tasminkhanelec-cmd/tic-tac-toe-hardware-gaming-interface-2023/media/Gameing Interface.png

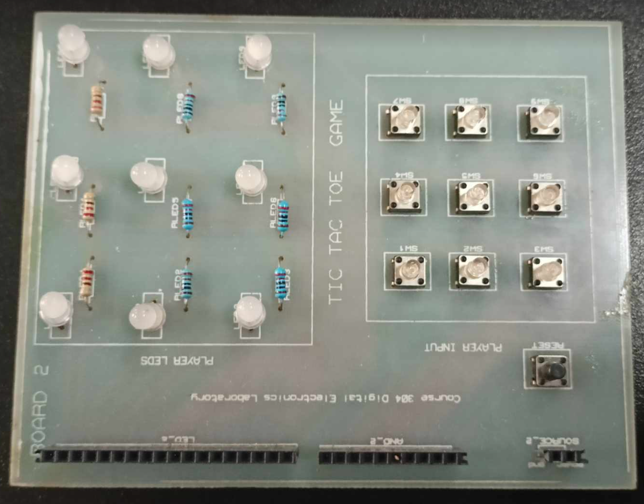
media/Gameing Interface.png
