tasminkhanelec-cmd/tic-tac-toe-hardware-gaming-interface-2023/circuit-design/schematics/player_identification_sim.png

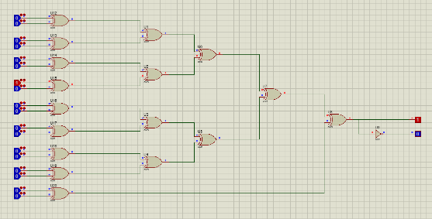
circuit-design/schematics/player_identification_sim.png
