tasminkhanelec-cmd/tic-tac-toe-hardware-gaming-interface-2023/circuit-design/schematics/stopping_game_sim.png

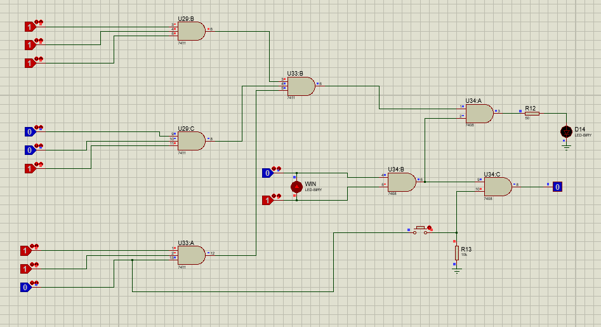
circuit-design/schematics/stopping_game_sim.png
