tasminkhanelec-cmd/tic-tac-toe-hardware-gaming-interface-2023/PCB-design/doc/Board1/Bottom Copper.pdf

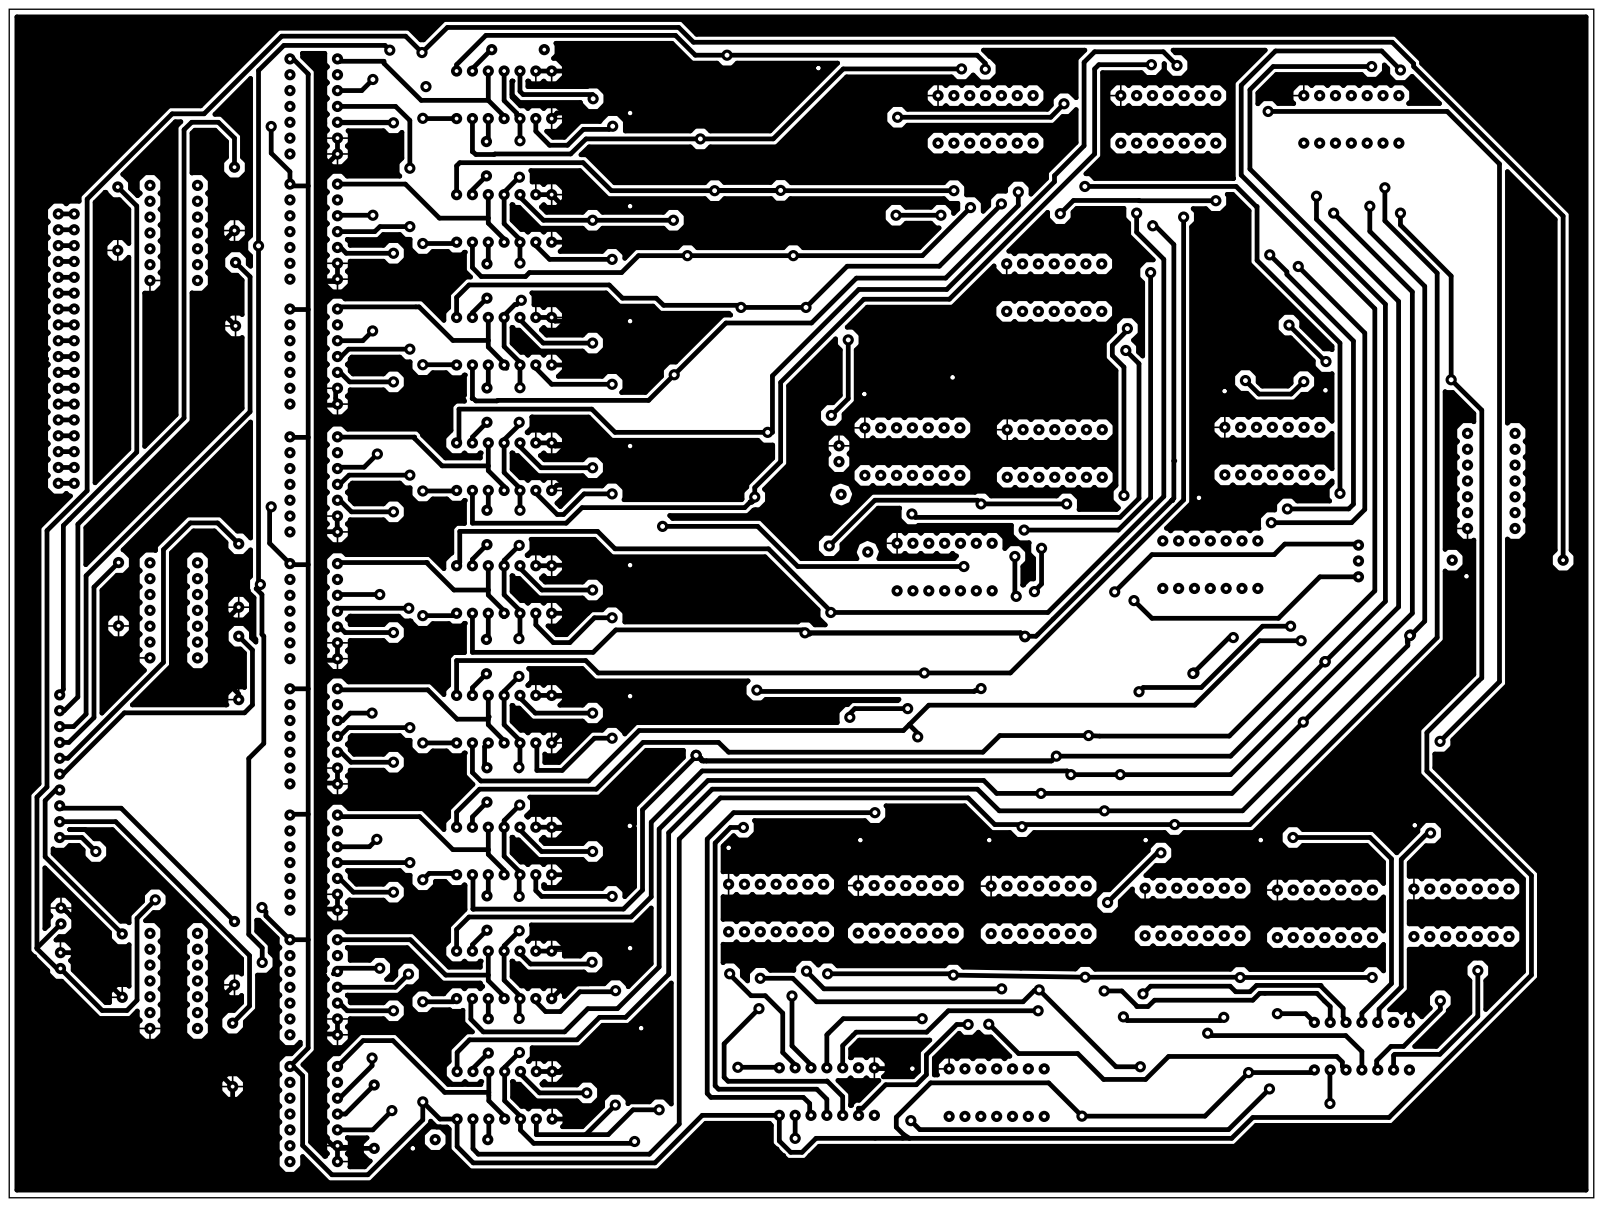
[picture p16: page 1]
