tasminkhanelec-cmd/tic-tac-toe-hardware-gaming-interface-2023/PCB-design/doc/Board1/Bottom Resist.pdf

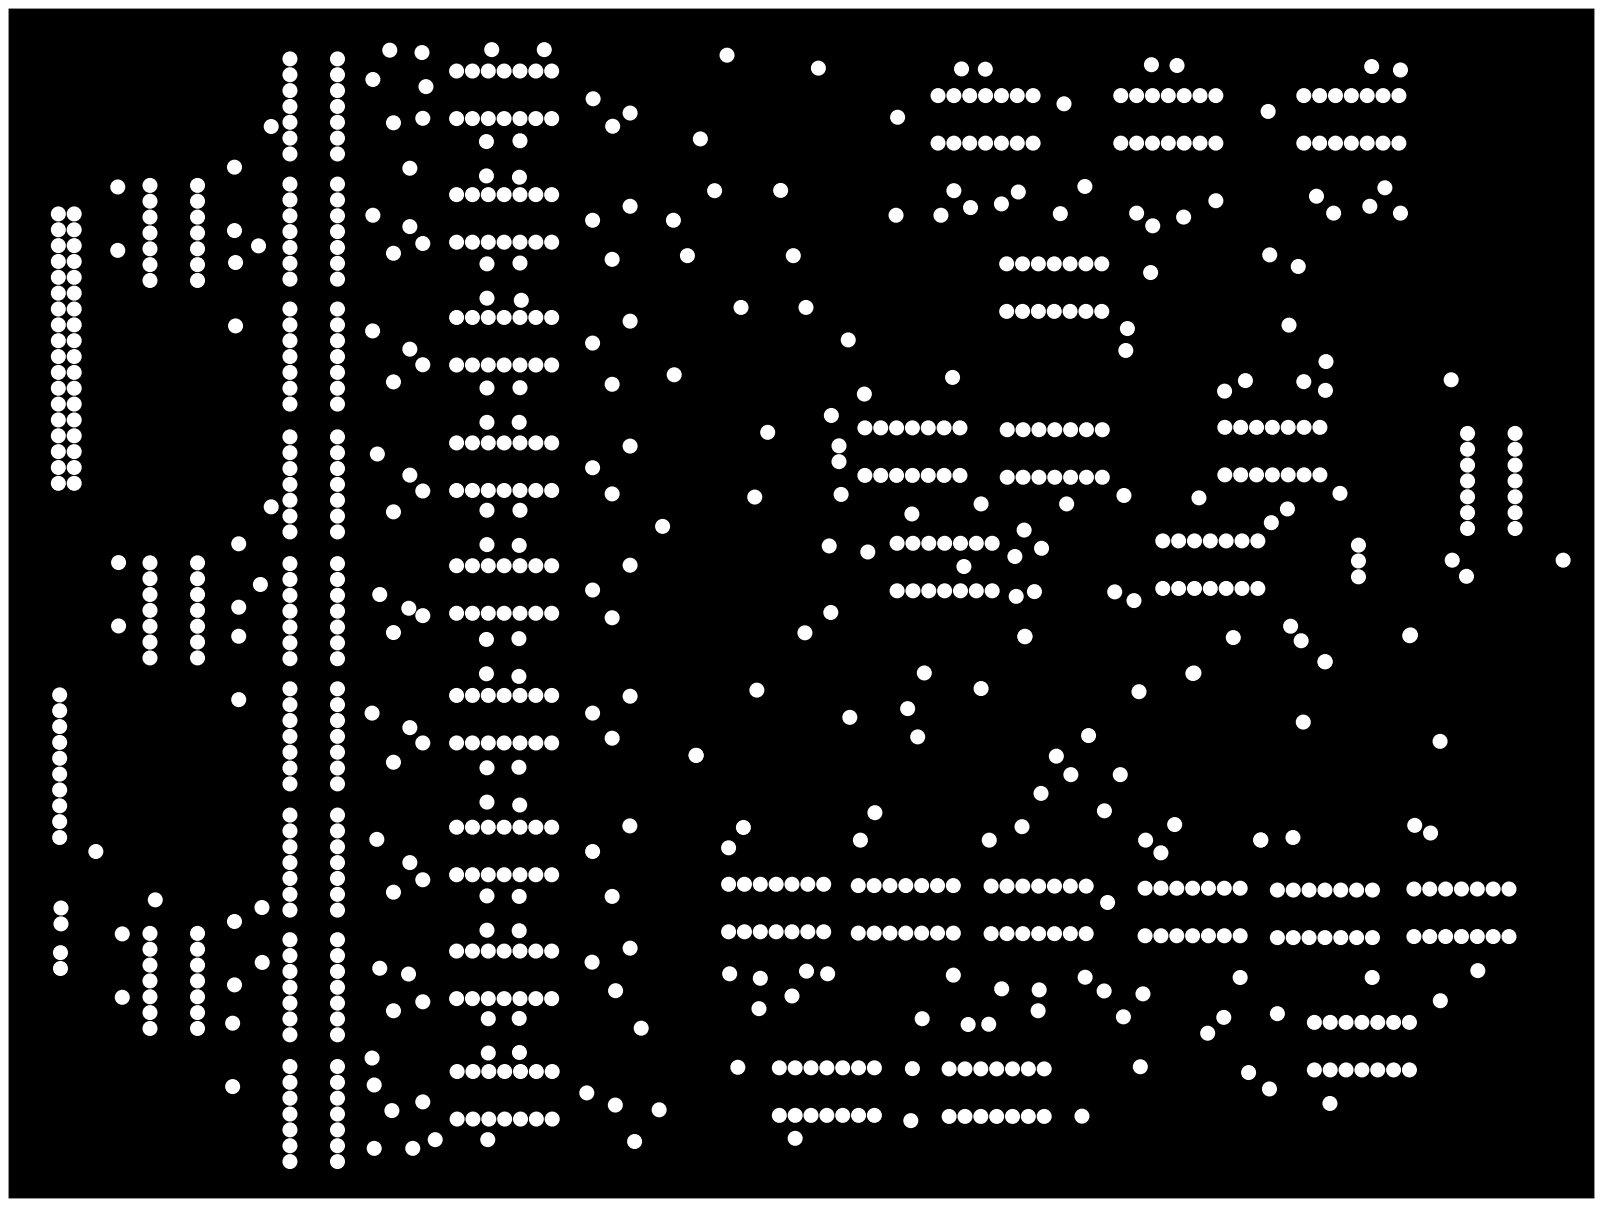
[picture p17: page 1]
