tasminkhanelec-cmd/tic-tac-toe-hardware-gaming-interface-2023/PCB-design/doc/Board1/Bottom Silk.pdf

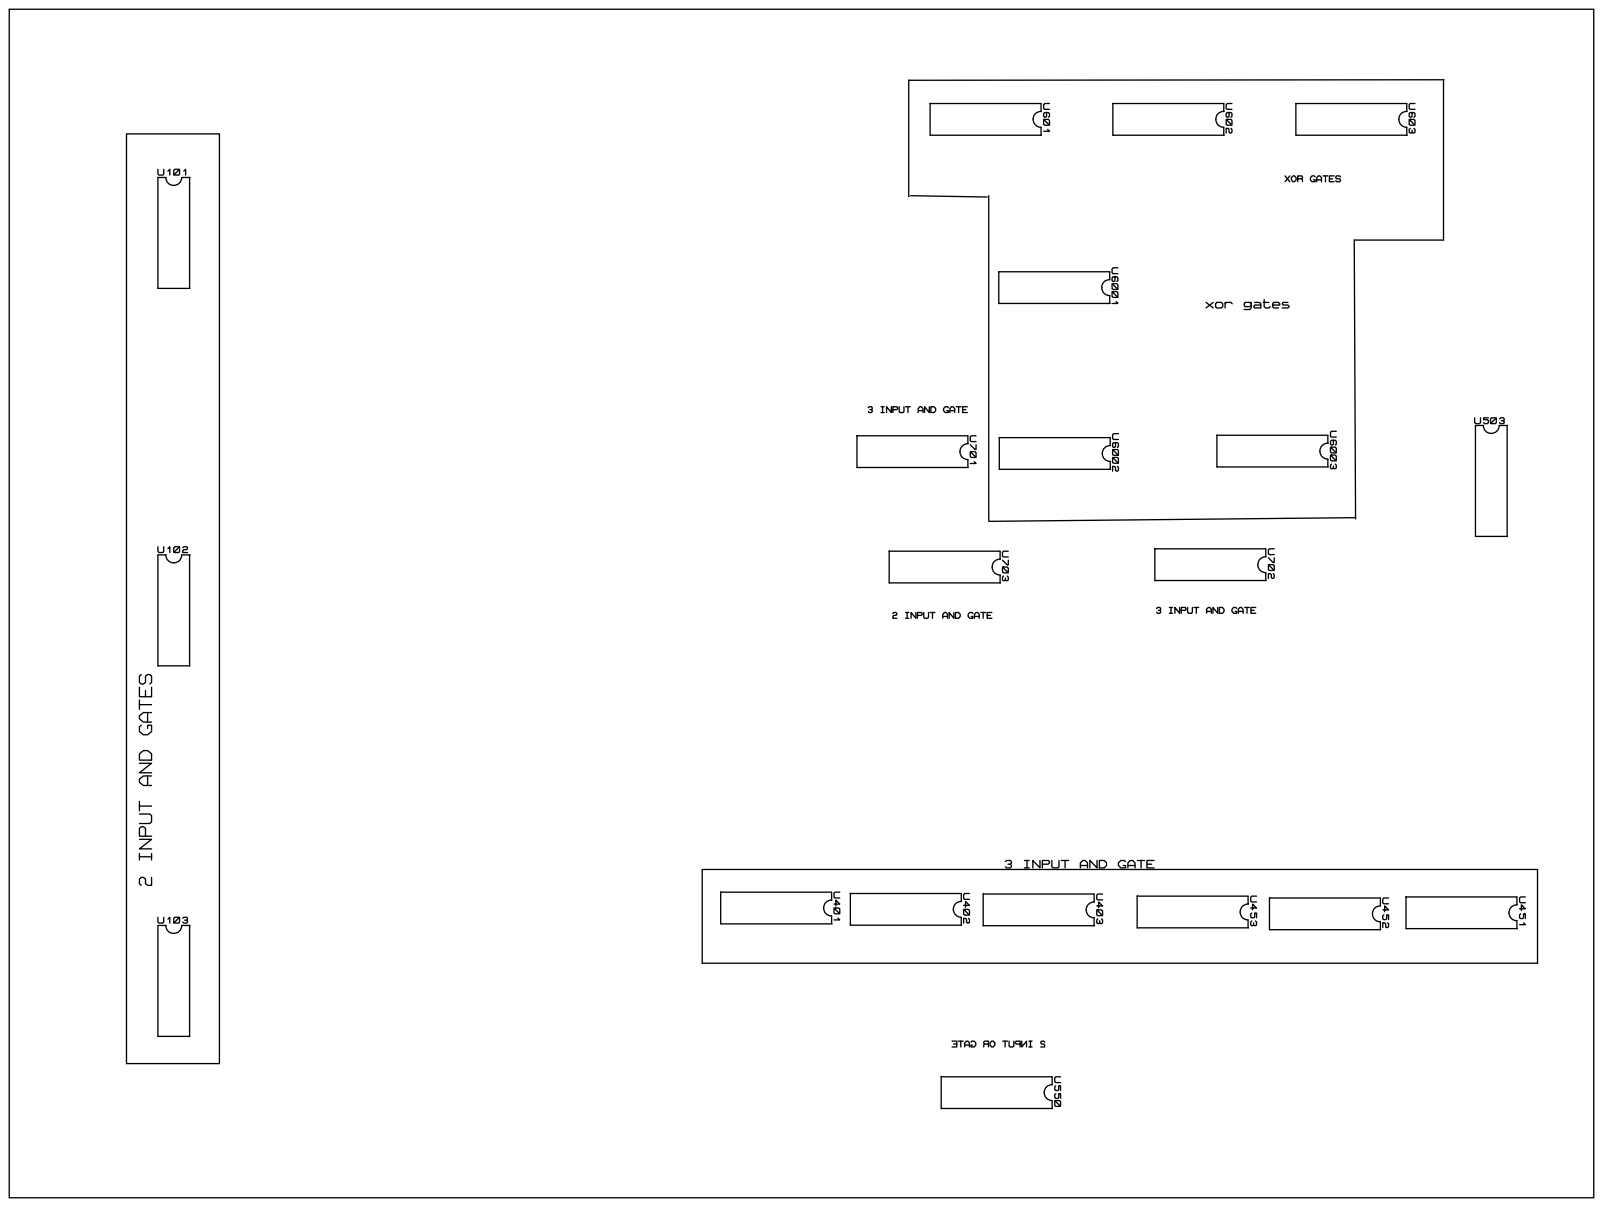
[picture p18: page 1]
