tasminkhanelec-cmd/tic-tac-toe-hardware-gaming-interface-2023/PCB-design/doc/Board1/Top Copper.pdf

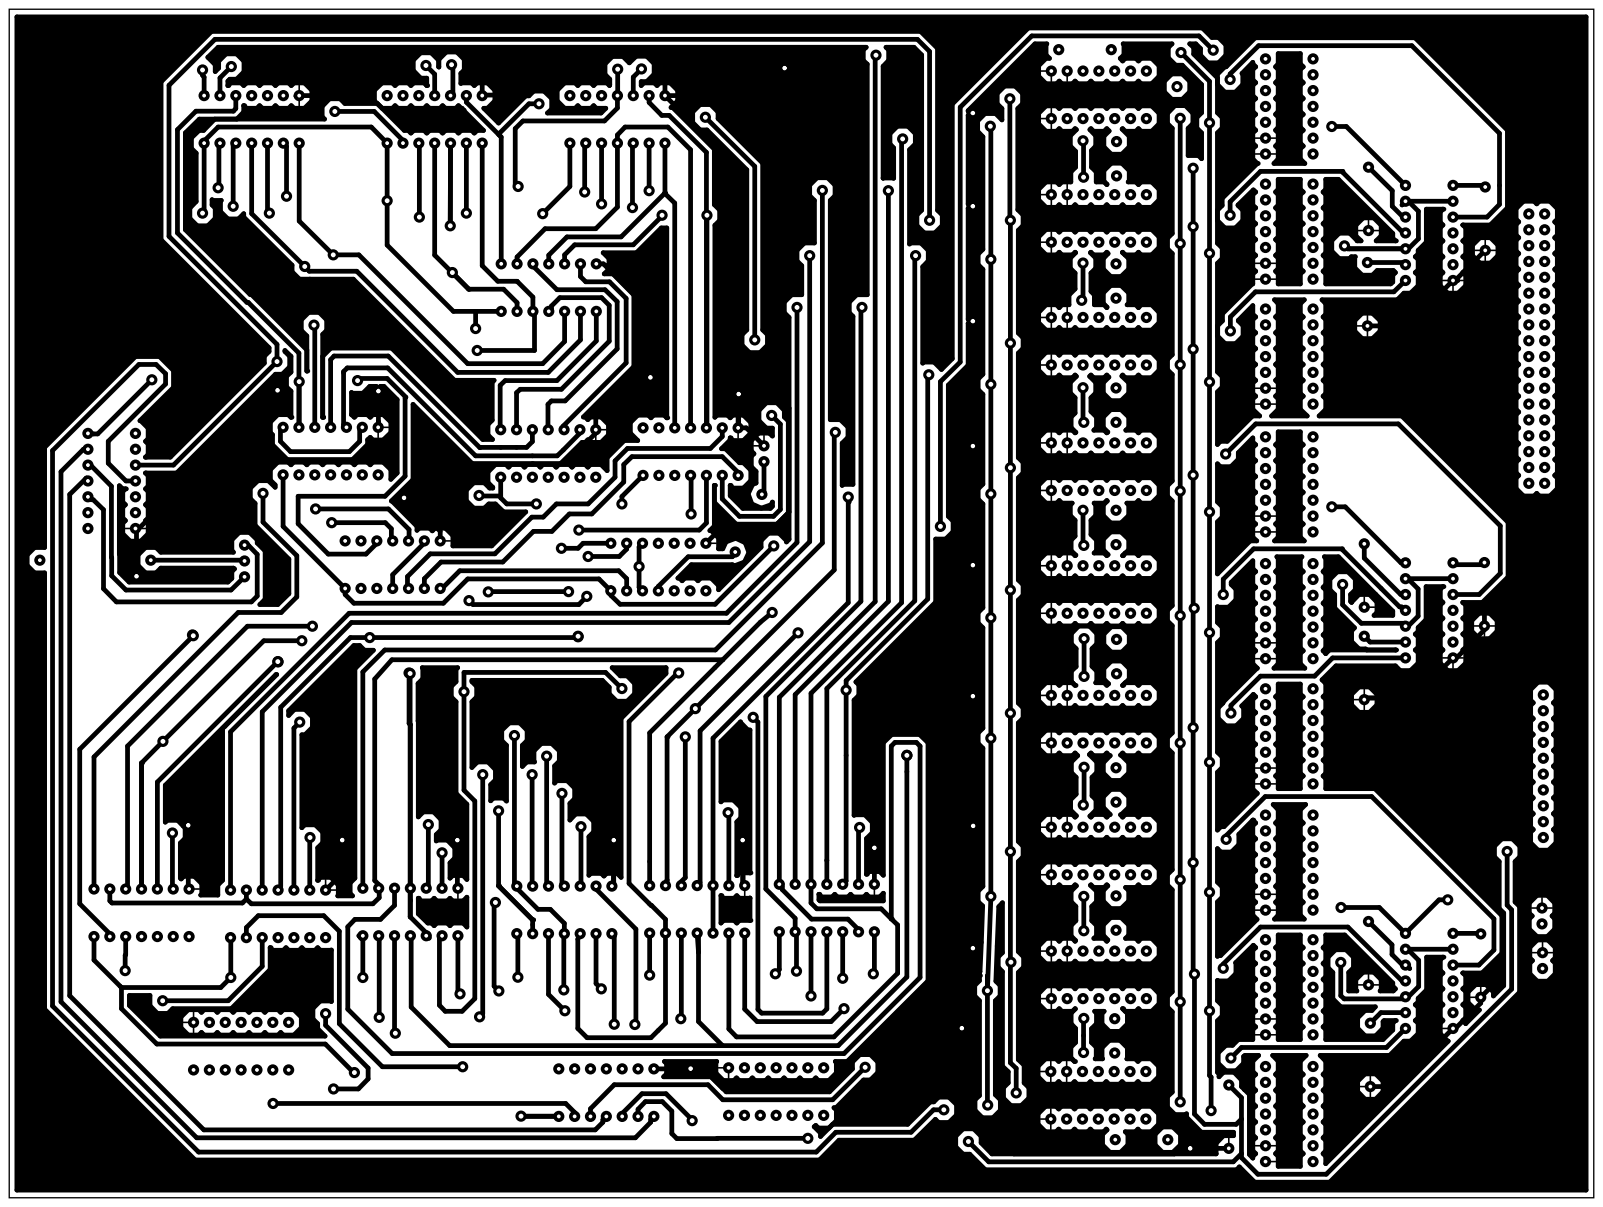
[picture p19: page 1]
