tasminkhanelec-cmd/tic-tac-toe-hardware-gaming-interface-2023/PCB-design/doc/Board1/Top Resist.pdf

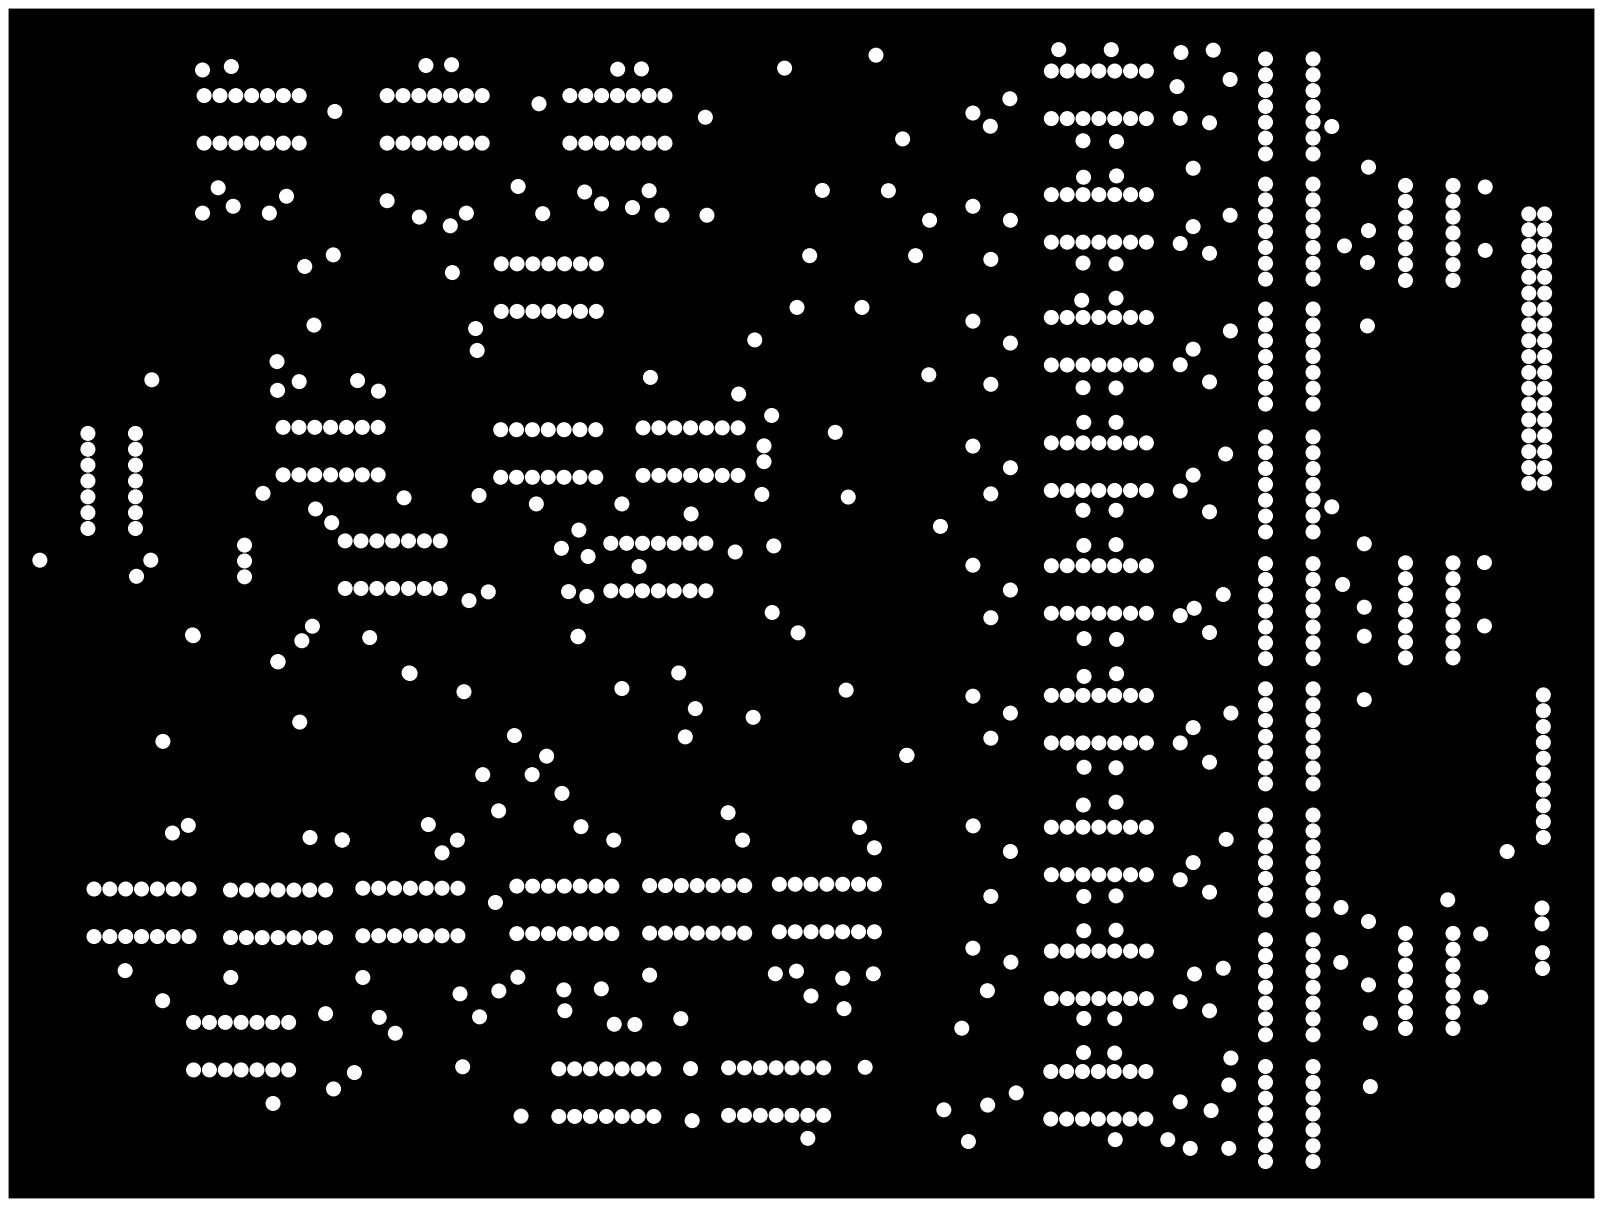
[picture p20: page 1]
