tasminkhanelec-cmd/tic-tac-toe-hardware-gaming-interface-2023/PCB-design/doc/Board2/Bottom Copper.pdf

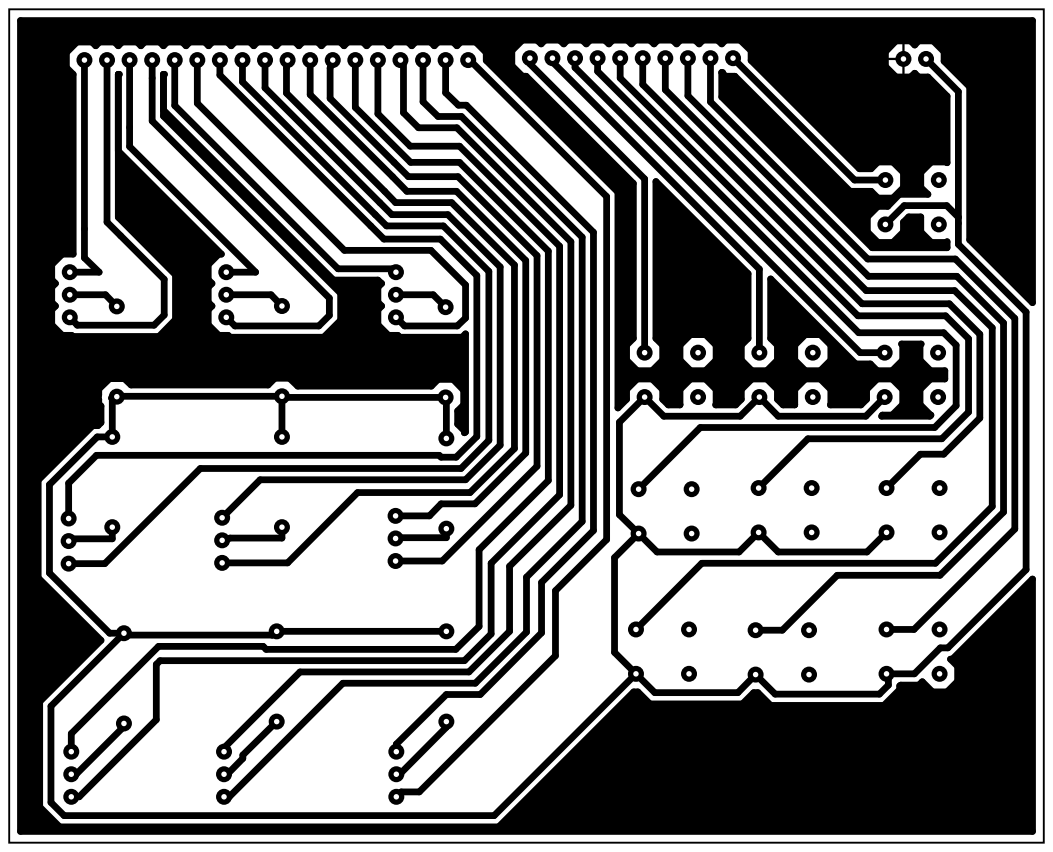
[picture p22: page 1]
