tasminkhanelec-cmd/tic-tac-toe-hardware-gaming-interface-2023/PCB-design/doc/Board2/Bottom Resist.pdf

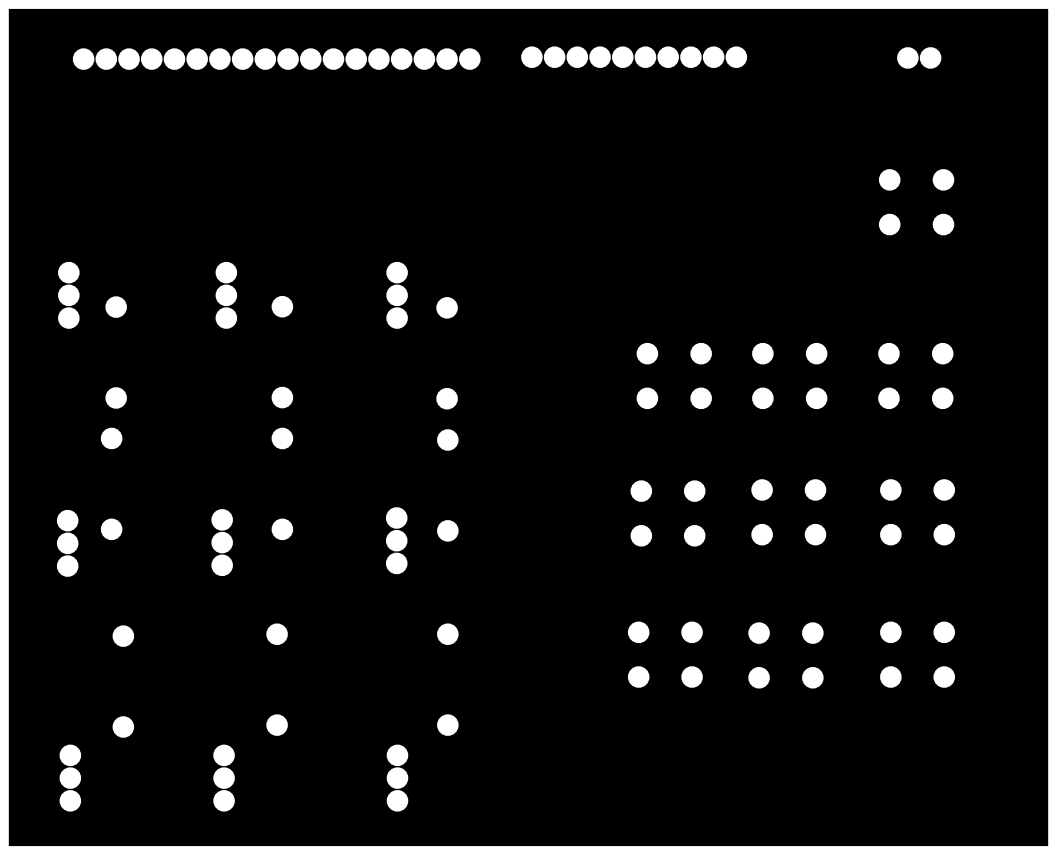
[picture p23: page 1]
