tasminkhanelec-cmd/tic-tac-toe-hardware-gaming-interface-2023/PCB-design/doc/Board2/Top Silk.pdf

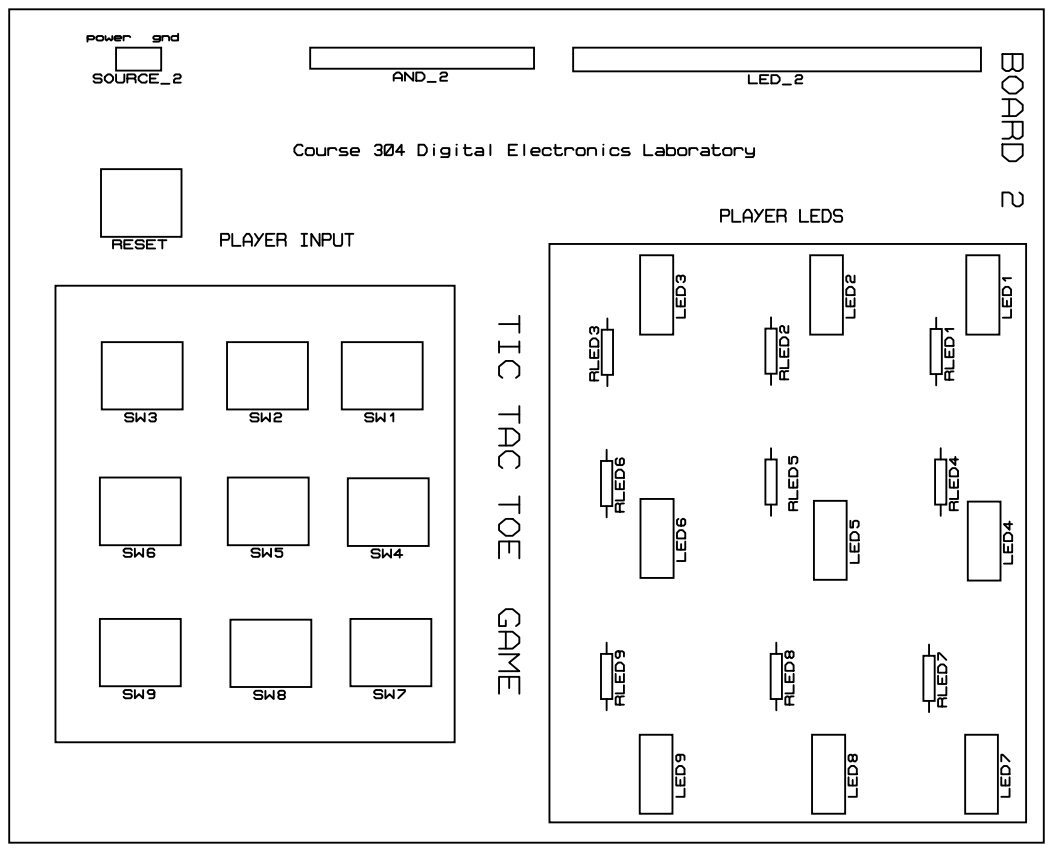
[picture p24: page 1]
