tasminkhanelec-cmd/tic-tac-toe-hardware-gaming-interface-2023/(list of files, drawings)

Other design files:
circuit-design/simulation/Game Over Simulation corrected.pdsprj
PCB-design/simulation/Game Over Board 1 for print.pdsprj
PCB-design/simulation/Game Over Board 2 for print.pdsprj
